Akoenigs2/SodaShop/PCB Design/sodaShop3D.png

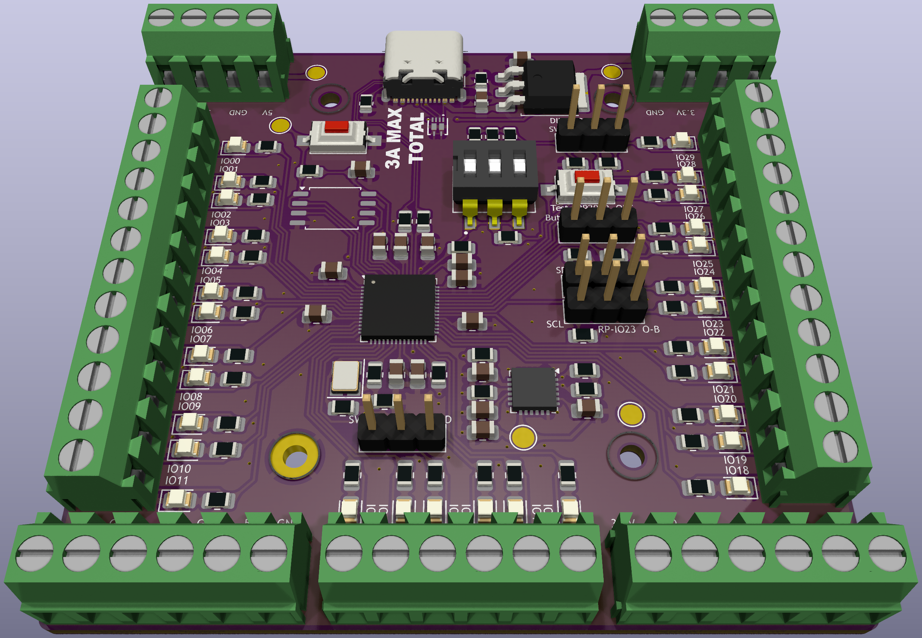
PCB Design/sodaShop3D.png
