Akoenigs2/SodaShop/Pictures/IMG_20250502_105455233.jpg

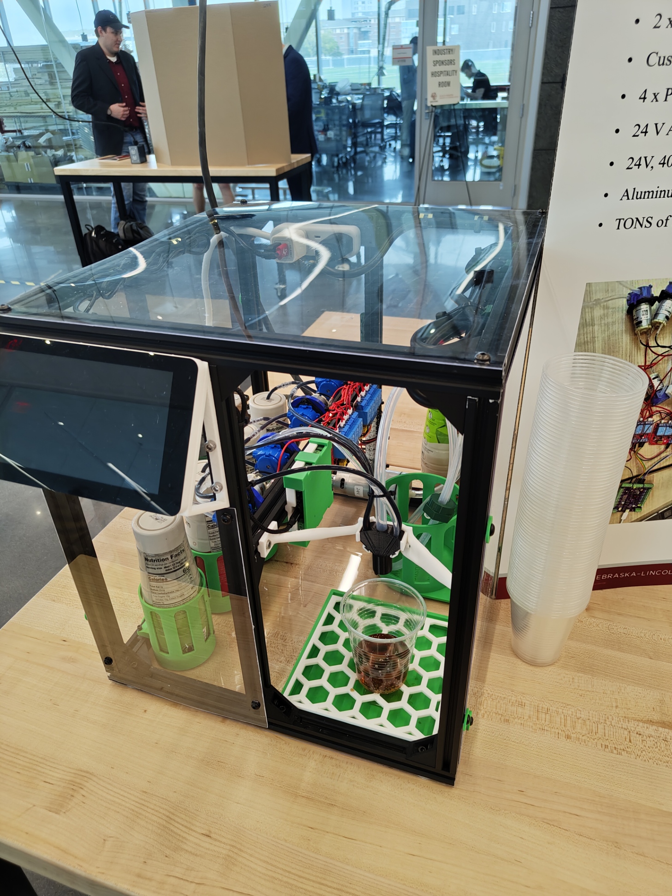
Pictures/IMG_20250502_105455233.jpg
