Akoenigs2/SodaShop/Senior Design Presentation/G185 SodaShop.pptx

## Senior Design Project: SodaShop

University of Nebraska – Lincoln
Department of Electrical and Computer Engineering

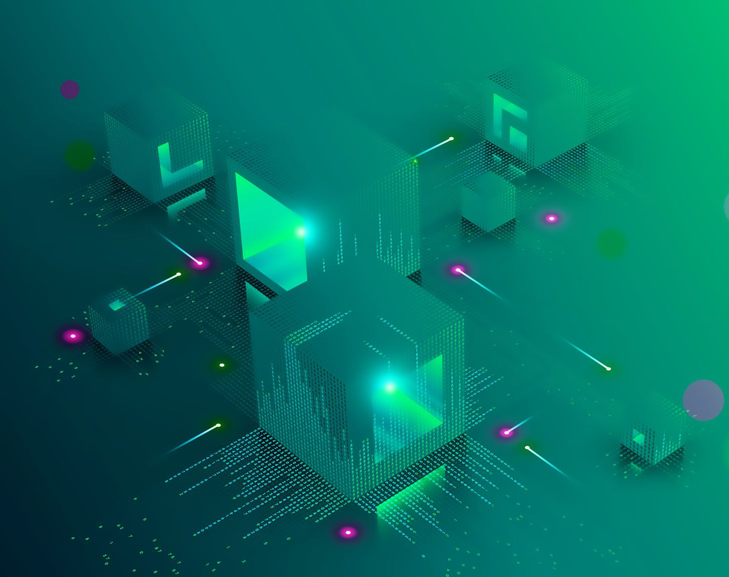
[picture p3: figure]

Justin Kleen, Austin Koenigs, Paul Litherland, Liam O’Malley, & Nic Witulski
12/6/24

## Overview

- An Outline of the Project
  - Background
  - Specifications
  - Explanation
  - Results
  - Conclusion
  - References

## Background & Problem to be Solved

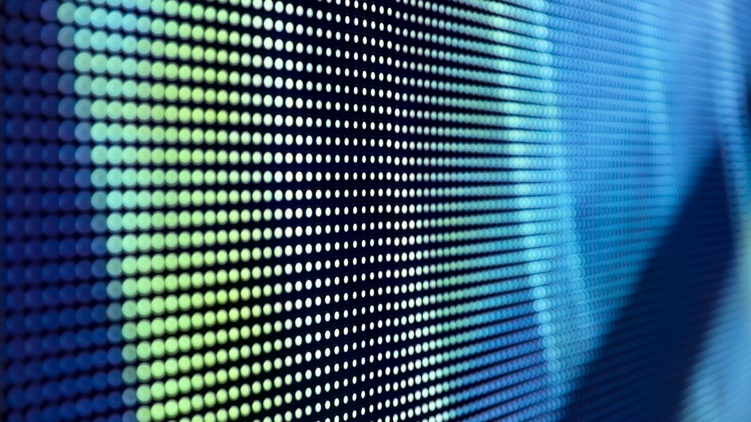
[picture p4: figure]

- Cans of soda and other soda mixing machines do not allow for customer customization and control.
- SodaShop allows for the ultimate customizability and control of soft drink creation bolstered by seamless automation.

## Specifications

- 24 V operating voltage
- 6A rated current draw
- 4 peristaltic pumps
- 1 air pump
- Rasberry pi 4B
- Custom pcb with rp2040
- 2 relay boards with 4 relays each
- 7in touchscreen interface

## Explanation

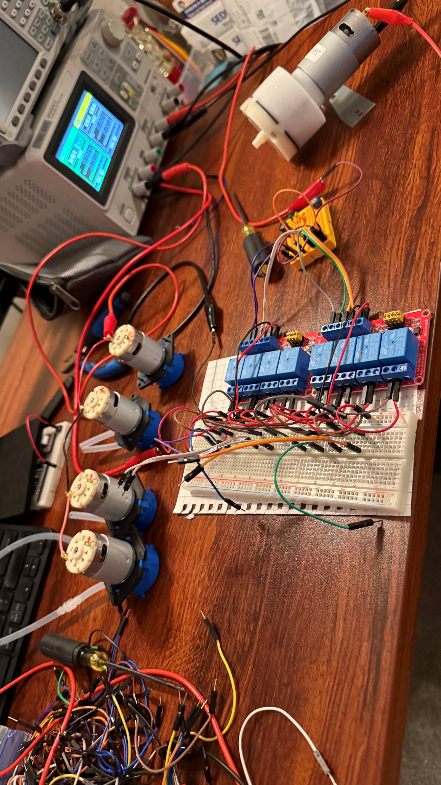
[picture p5: figure]

- UI Library:
  - GUIZero
- Relays:
  - Will be controlled by custom pcb receiving signals from raspberry pi interface
- Food Safety

## Summary

- Functional UI
- Automatic pumping and pouring of drinks

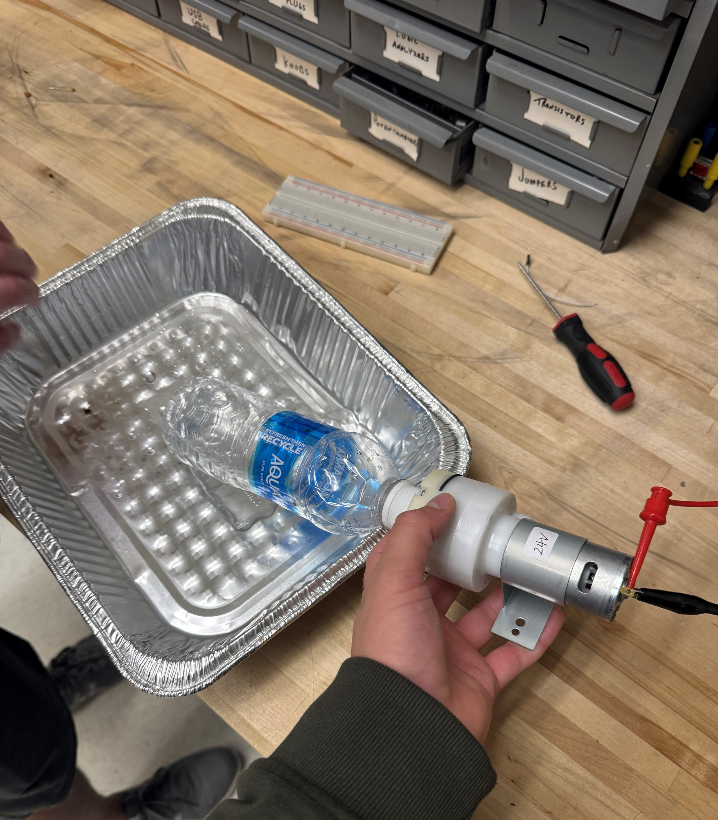
[picture p6: figure]

## References

## Conclusion

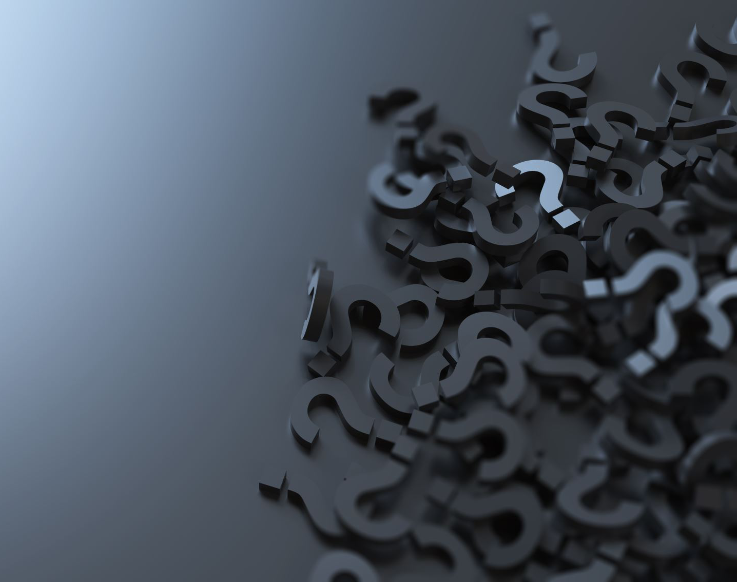
[picture p7: figure]
Many question marks on black background

- Thank you!!
- Questions?
