Akoenigs2/SodaShop/Spec Sheet/G185_ECEN495_SodaShop_Spec_Sheet.pdf

Justin Kleen – Austin Koenigs – Paul Litherland – Liam O’Malley – Nic Witulski

# SodaShop

7” Touchscreen Interface | Carbonated –or– Still Water | Up to Four Syrup Options | 120 VAC | 69 W

Pumping Current/Power
sxWater | 0.41 A | 09.84 W
+1 Syrups | 0.61 A | 14.64 W
+2 Syrups | 0.82 A | 19.68 W
+3 Syrups | 1.03 A | 24.72 W
+4 Syrups | 1.24 A | 29.76 W

Standard Features
- Operation is controlled via a 7” touchscreen providing the user with complete control of ratios between water and each individual flavor.
- SodaShop allows a selection of pre-determined volumes at a press of a button.
- SodaShop is capable of storing hundreds of flavor combinations and five user-determined favorite recipes.
- Stored combinations automatically fall into valid and invalid recipe bins based on the entered current syrups installed to inform the user of selectable saved combinations based on current availability.
- Favorites can quickly be dispensed from the home screen to provide a drink with minimal wait time.
- The system can plug directly into a wall 120VAC outlet to provide fast and easy access and operation.
- SodaShop uses four peristaltic pumps for syrup control providing precise control and easy-to-swap tubing for replacement and cleaning.
- Main water is pumped via air pressure to prevent cavitation maximizing carbonation for the optimal drinking experience. This method also provide self-pressure relief preventing overpressure conditions in the water container.
- The system is designed to allow any standard 2-liter bottle for water. Flavors are currently relegated to using third-party syrups bottle with modified caps.

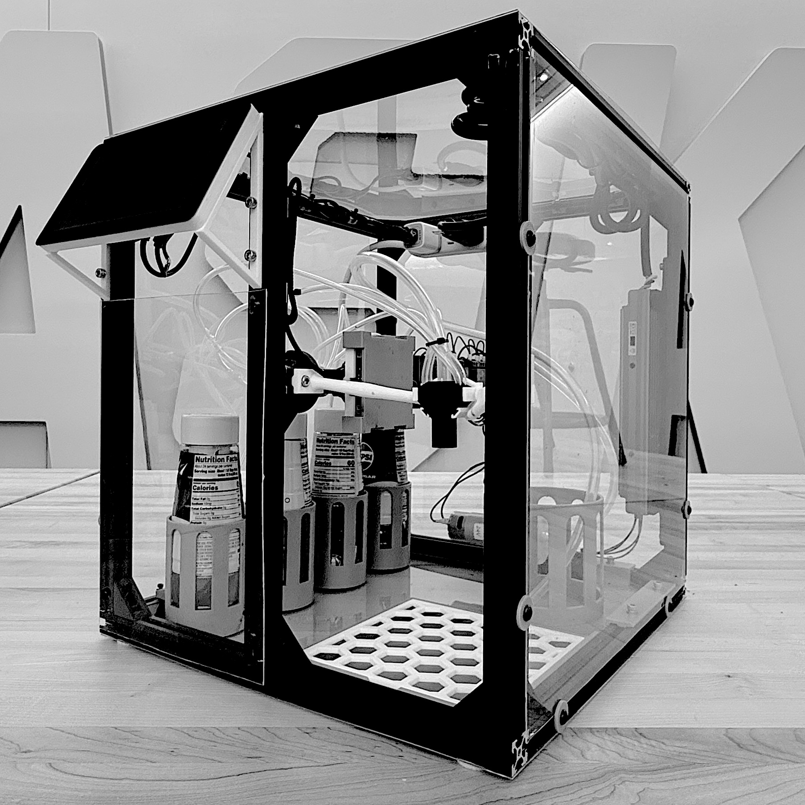
[picture p17: figure]

## Component Ratings

24 VDC Power Supply | AC Input | DC Output | Rated Current | Rated Power | Input Freq | Input Type
100-240 VAC | 24 VDC | 6 A | 144 W | 50-60 Hz | 3-Terminal AC
5 VDC Power Supply | AC Input | DC Output | Rated Current | Rated Power | Input Freq | Input Type
110-220 VAC | 5 VDC | 3 A | 15 W | 50-60 Hz | 2-Terminal AC
Main Water (Air) Pump | Voltage | Max Power | Tubing Size | Flow Rate | Max Pressure | Safety
24 VDC | 10 W | 5/32” ID | ∼ 60 oz/min | 65 kPa | Overpressure
Peristaltic Syrup Pumps (4) | Voltage | Max Power | Tubing Size | Flow Rate | Motor Life | Rollers
24 VDC | 5 W | 3 mm ID | 90 ml/min | 800 hrs | 3

System Tubing

Main Water & Air | Flavors/Syrup
Inner Diameter: | 5/32” | 3 mm
Outer Diameter: | 1/4” | 5 mm
Raspberry Pi — RP2040 | Voltage | Max Power | Communication | GPIO Voltage
5 VDC | 15 W | Serial (USB-C) | 3.3 VDC
Display | Voltage | Max Power | Communication | Size | Touch
5 VDC | 15 W | Direct | 7 ” | Capacitive
Motor Control Relays | Voltage | Max Load (Each) | Safety | Trig. Voltage/Current
24 VDC | 30 VDC — 10 A | Opto-Isolation | 0-8 V (low) — 5 mA

UNL G185 EE Capstone 2024–2025-1
