Akoenigs2/SodaShop/PCB Design/sodaShopLayout.png

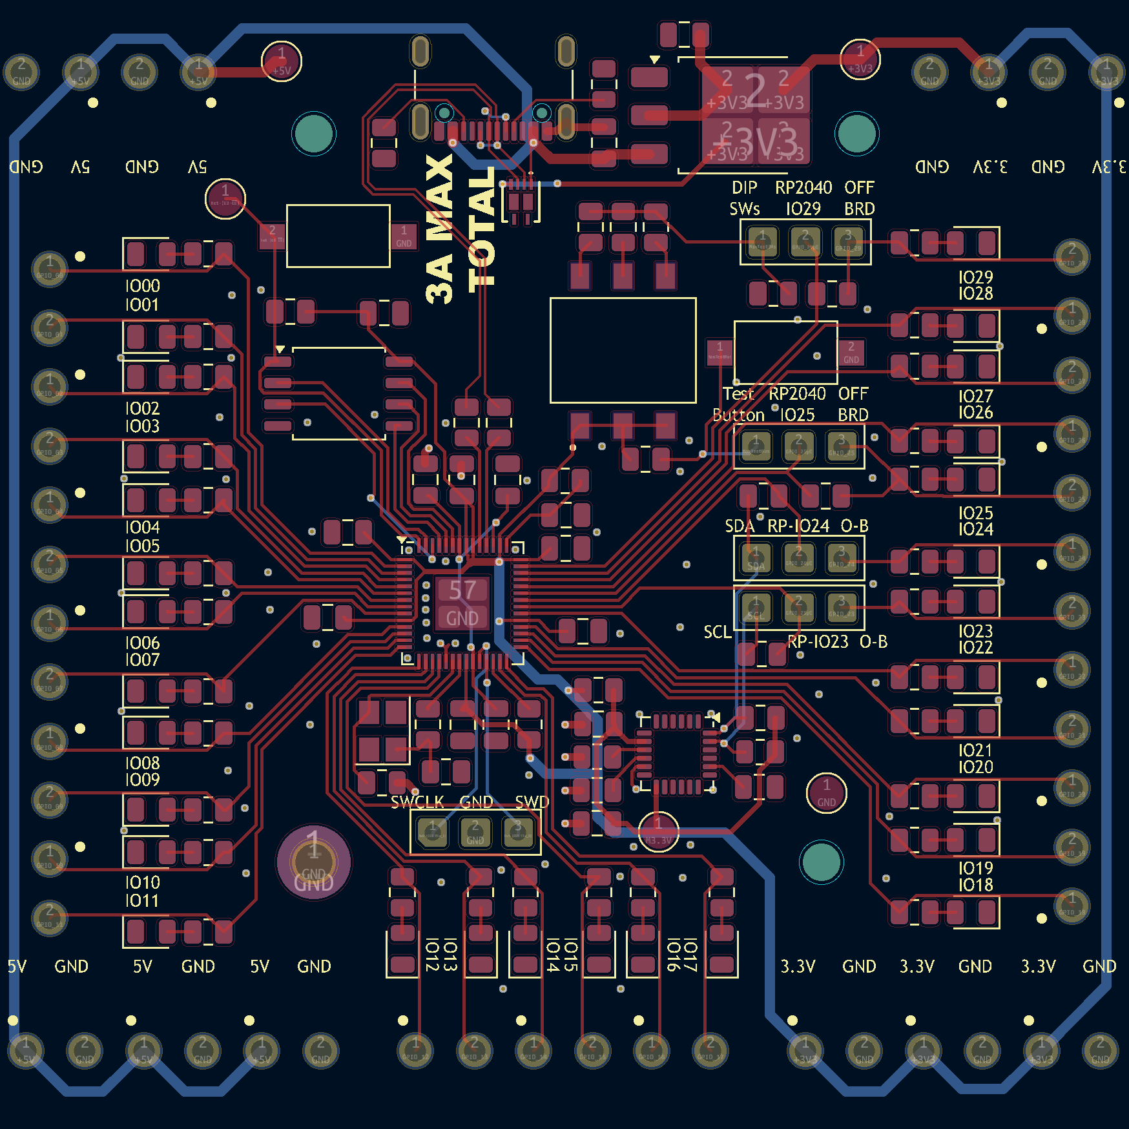
PCB Design/sodaShopLayout.png
