Akoenigs2/SodaShop/Pictures/IMG_20250225_141645415.jpg

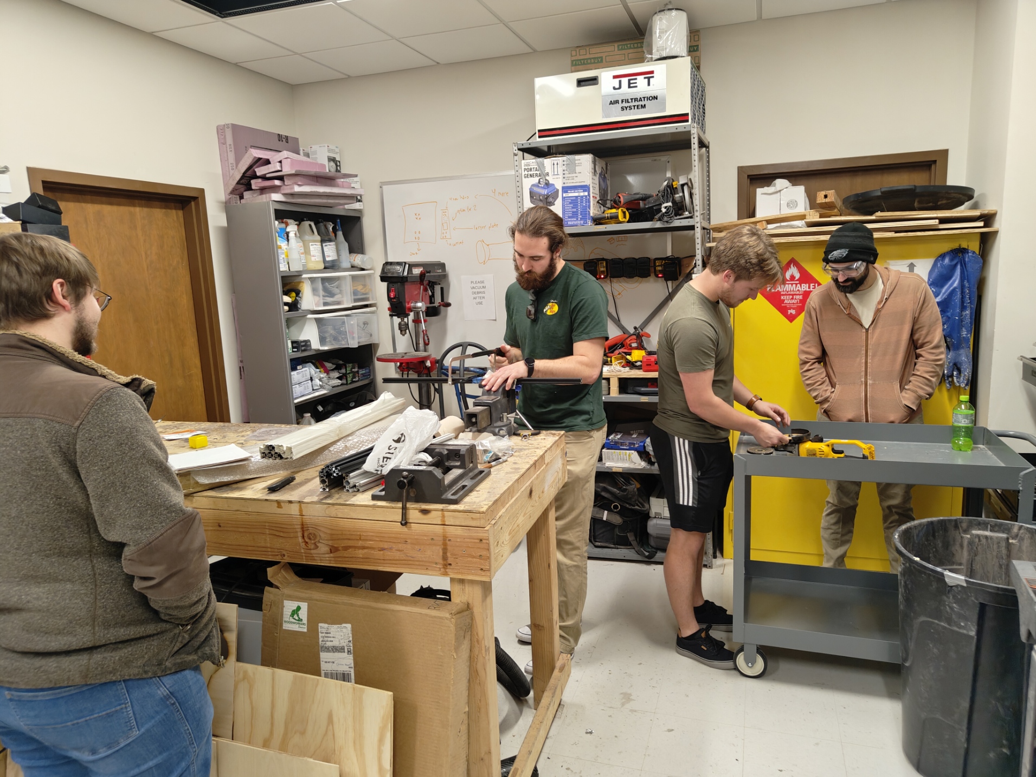
Pictures/IMG_20250225_141645415.jpg
