Akoenigs2/SodaShop/Pictures/IMG_20250225_143517592.jpg

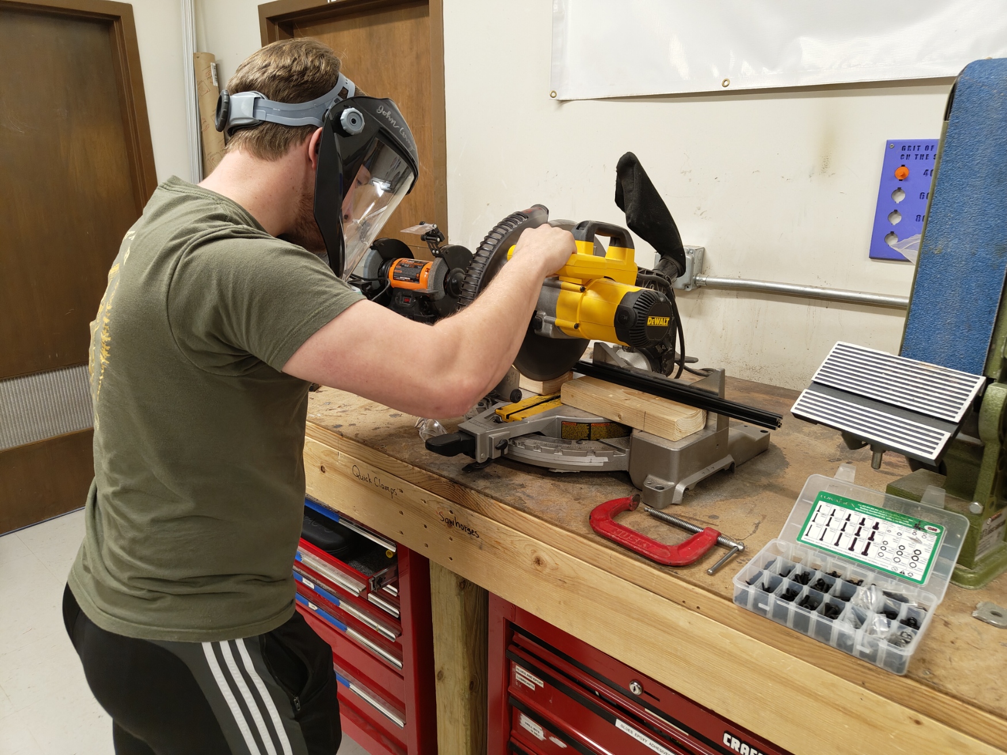
Pictures/IMG_20250225_143517592.jpg
