Akoenigs2/SodaShop/Pictures/IMG_20250225_143700488.jpg

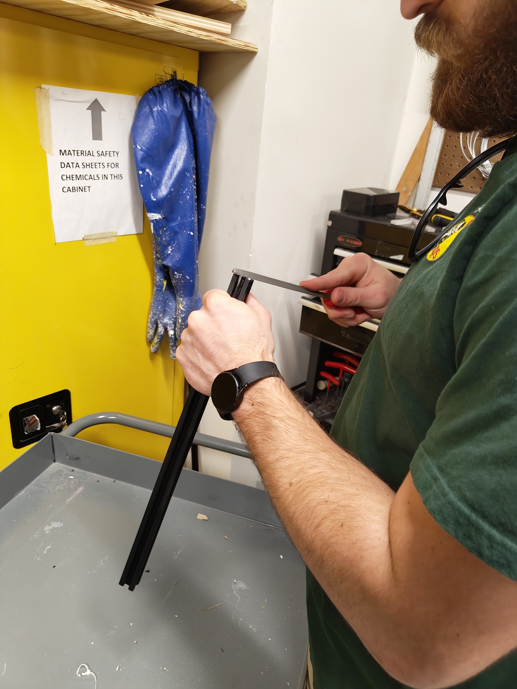
Pictures/IMG_20250225_143700488.jpg
