Akoenigs2/SodaShop/Pictures/IMG_20250304_141928702.jpg

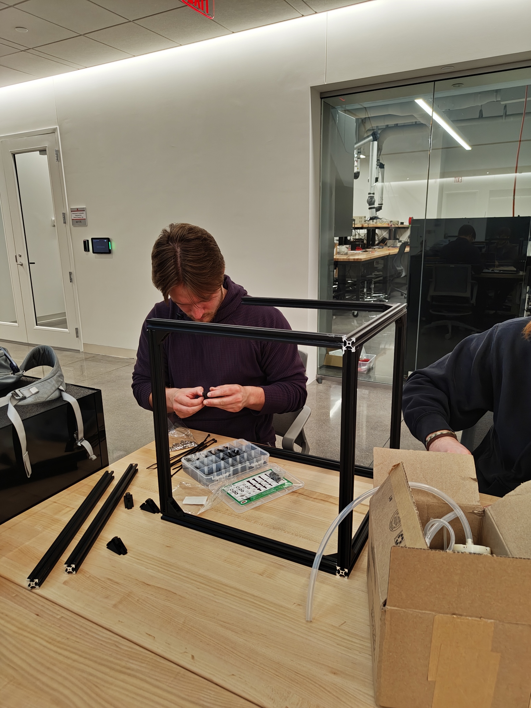
Pictures/IMG_20250304_141928702.jpg
