Akoenigs2/SodaShop/Pictures/IMG_20250304_145719513.jpg

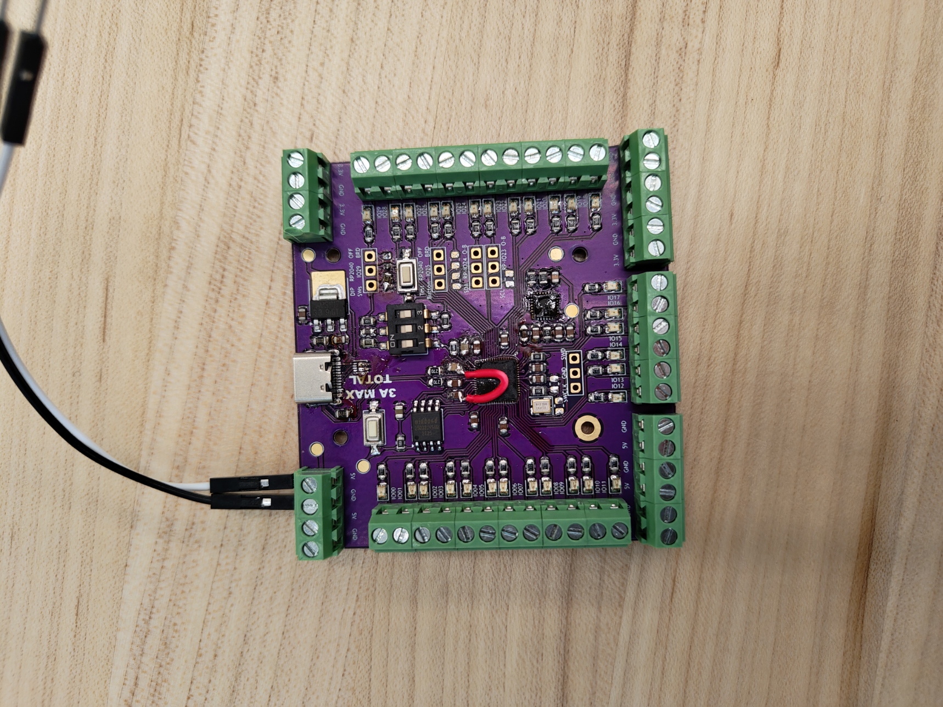
Pictures/IMG_20250304_145719513.jpg
