Akoenigs2/SodaShop/Pictures/IMG_20250325_144047182.jpg

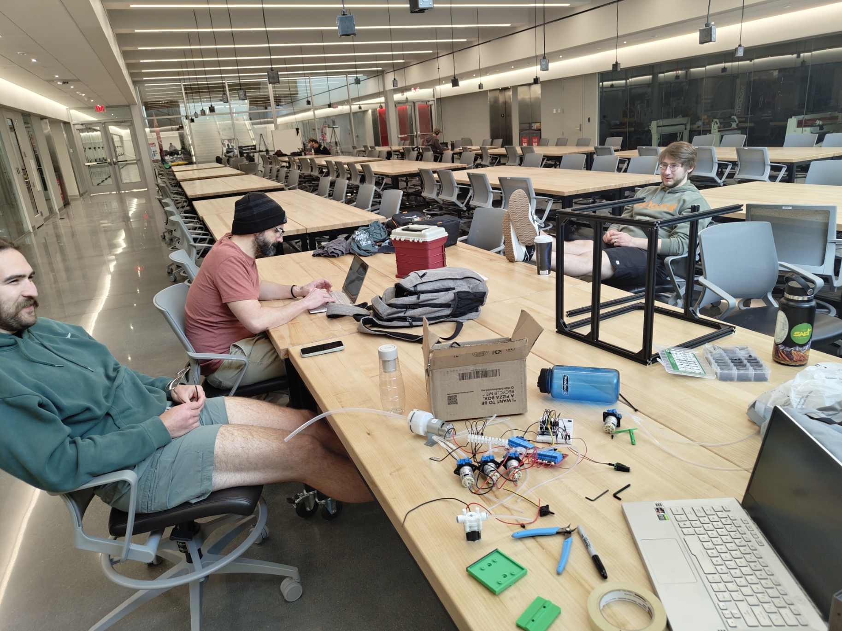
Pictures/IMG_20250325_144047182.jpg
