Akoenigs2/SodaShop/Pictures/IMG_20250325_145647819.jpg

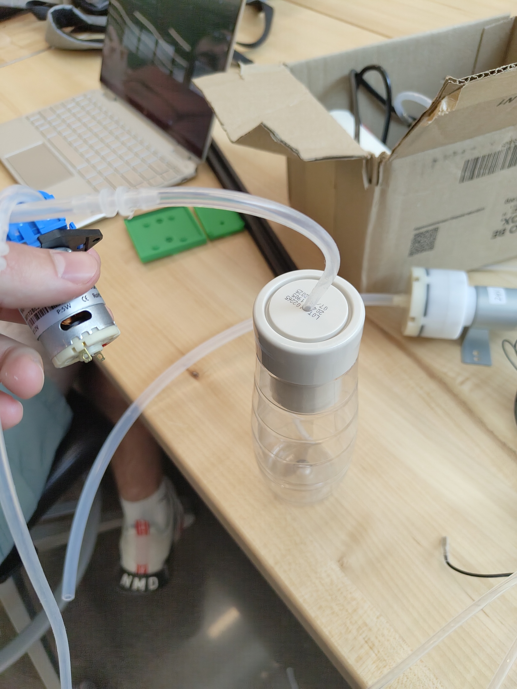
Pictures/IMG_20250325_145647819.jpg
