Akoenigs2/SodaShop/Pictures/IMG_20250401_142619781.jpg

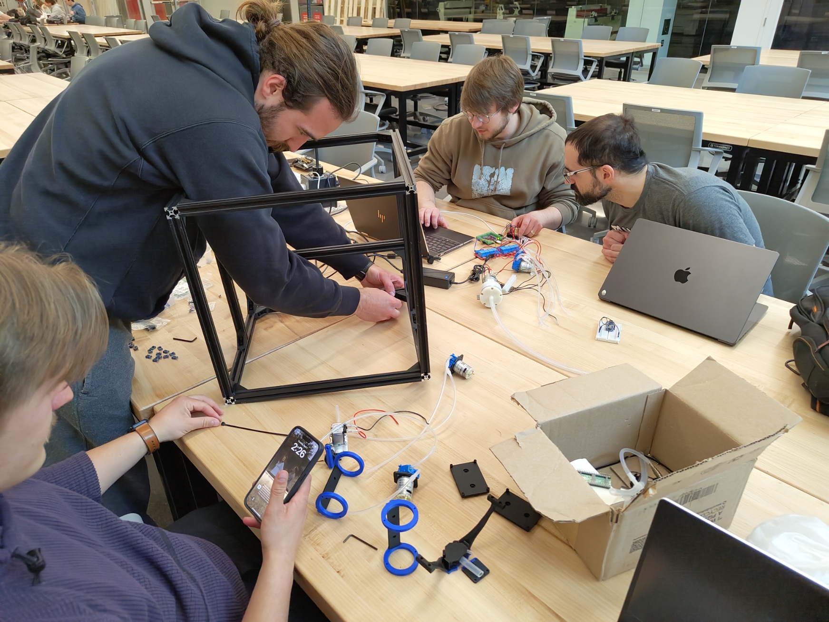
Pictures/IMG_20250401_142619781.jpg
