Akoenigs2/SodaShop/Pictures/IMG_20250401_144759305.jpg

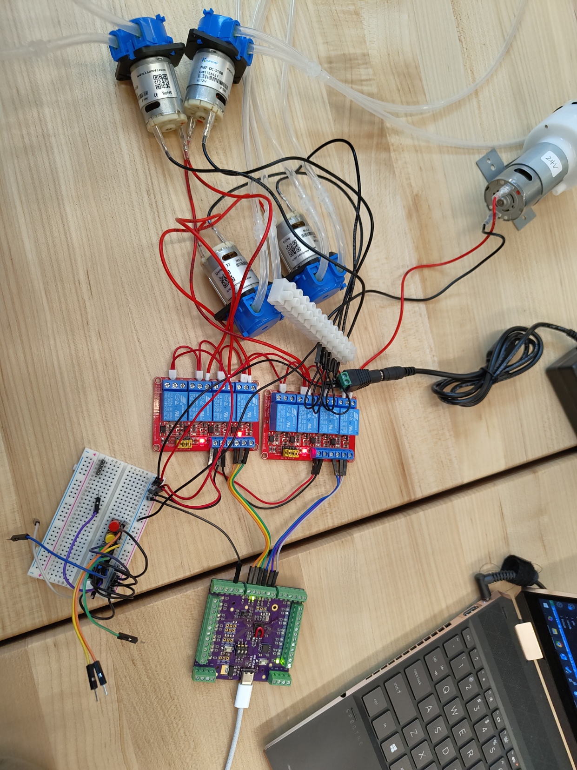
Pictures/IMG_20250401_144759305.jpg
