Akoenigs2/SodaShop/Pictures/IMG_20250402_194000655.jpg

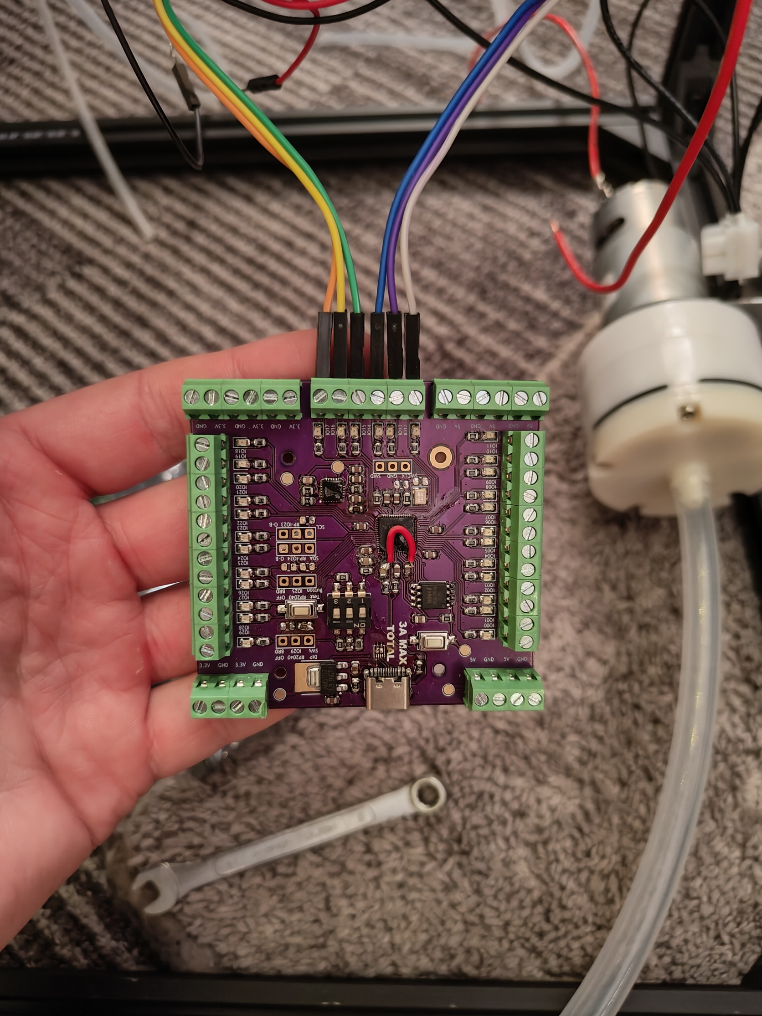
Pictures/IMG_20250402_194000655.jpg
