Akoenigs2/SodaShop/Pictures/IMG_20250408_150435291.jpg

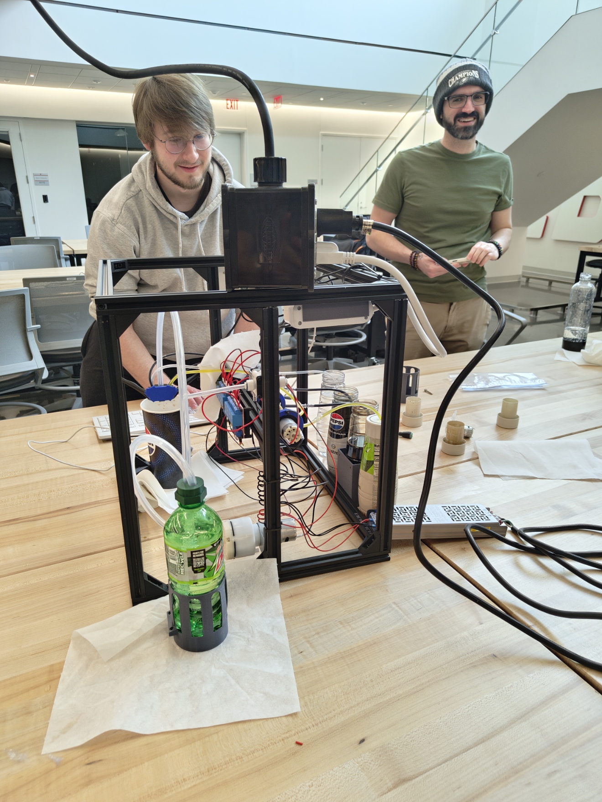
Pictures/IMG_20250408_150435291.jpg
