Akoenigs2/SodaShop/Pictures/IMG_20250423_213137417.jpg

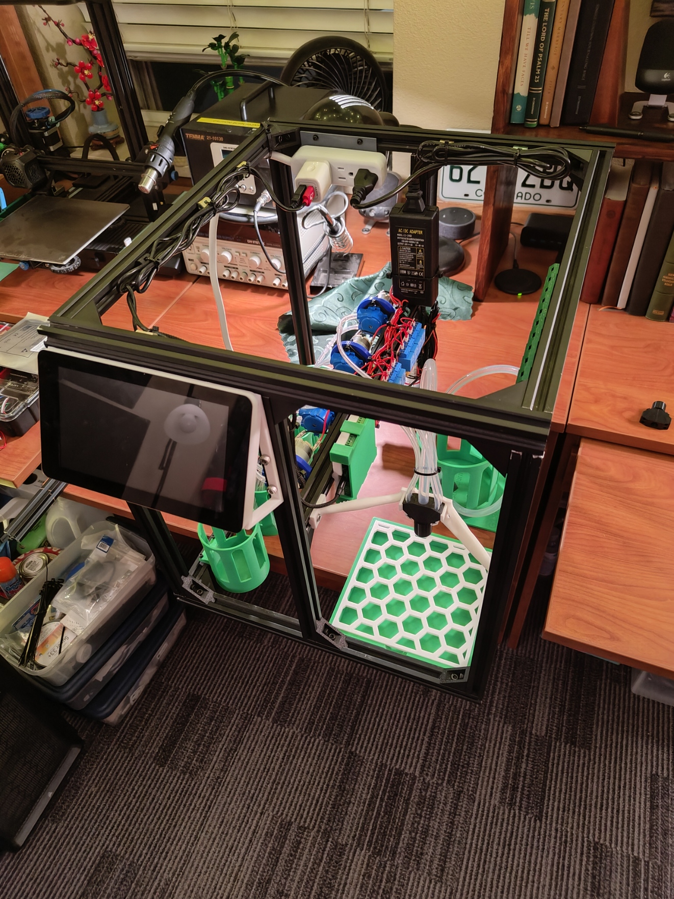
Pictures/IMG_20250423_213137417.jpg
