Akoenigs2/SodaShop/Pictures/IMG_20250423_213144863.jpg

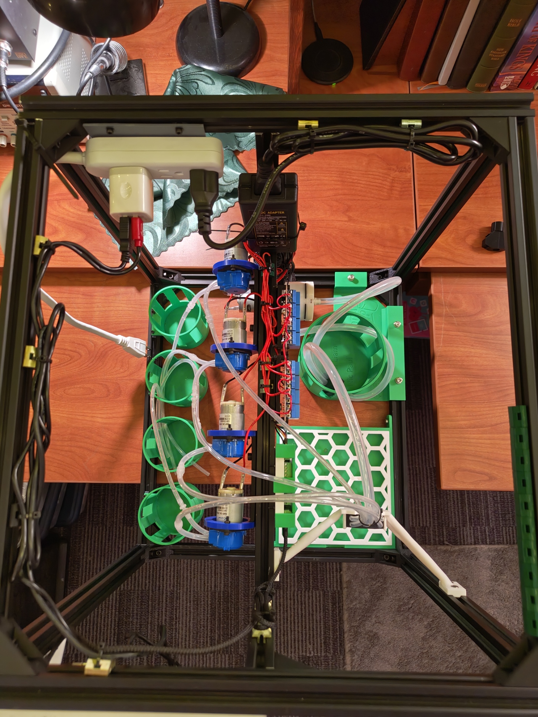
Pictures/IMG_20250423_213144863.jpg
