Akoenigs2/SodaShop/Pictures/IMG_20250502_105539470.jpg

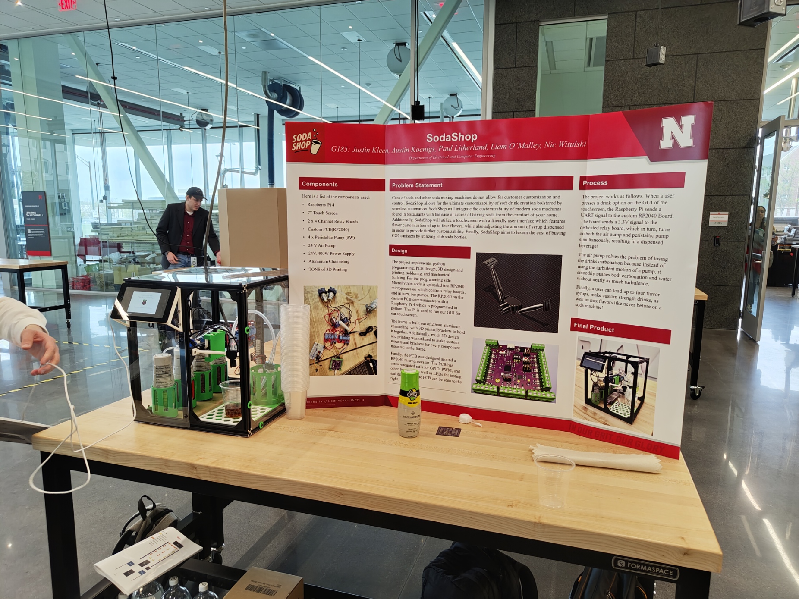
Pictures/IMG_20250502_105539470.jpg
