Akoenigs2/SodaShop/Pictures/IMG_20250502_141535261.jpg

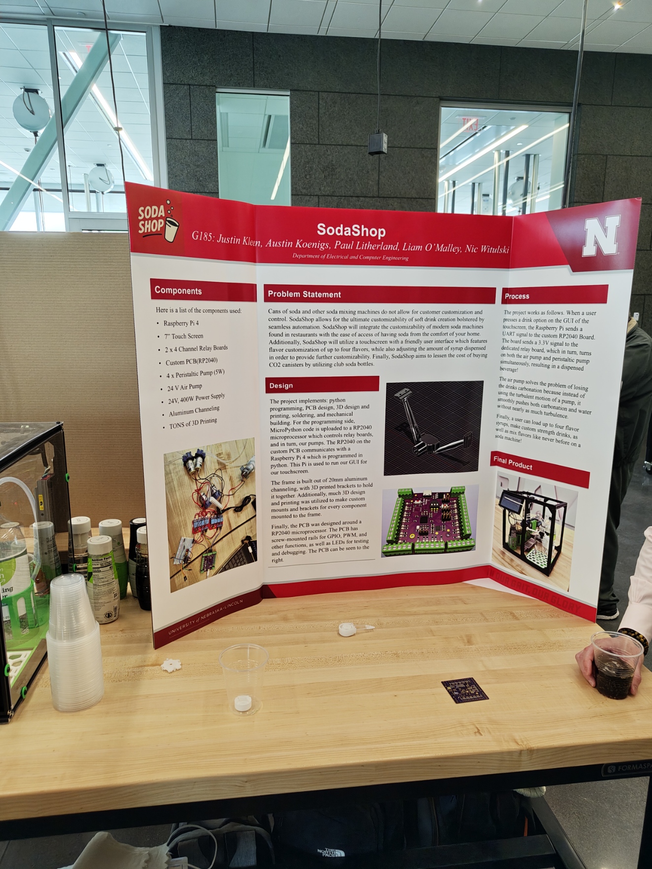
Pictures/IMG_20250502_141535261.jpg
