Akoenigs2/SodaShop/Spec Sheet/Reference Documentation/peristaltic pump info.png

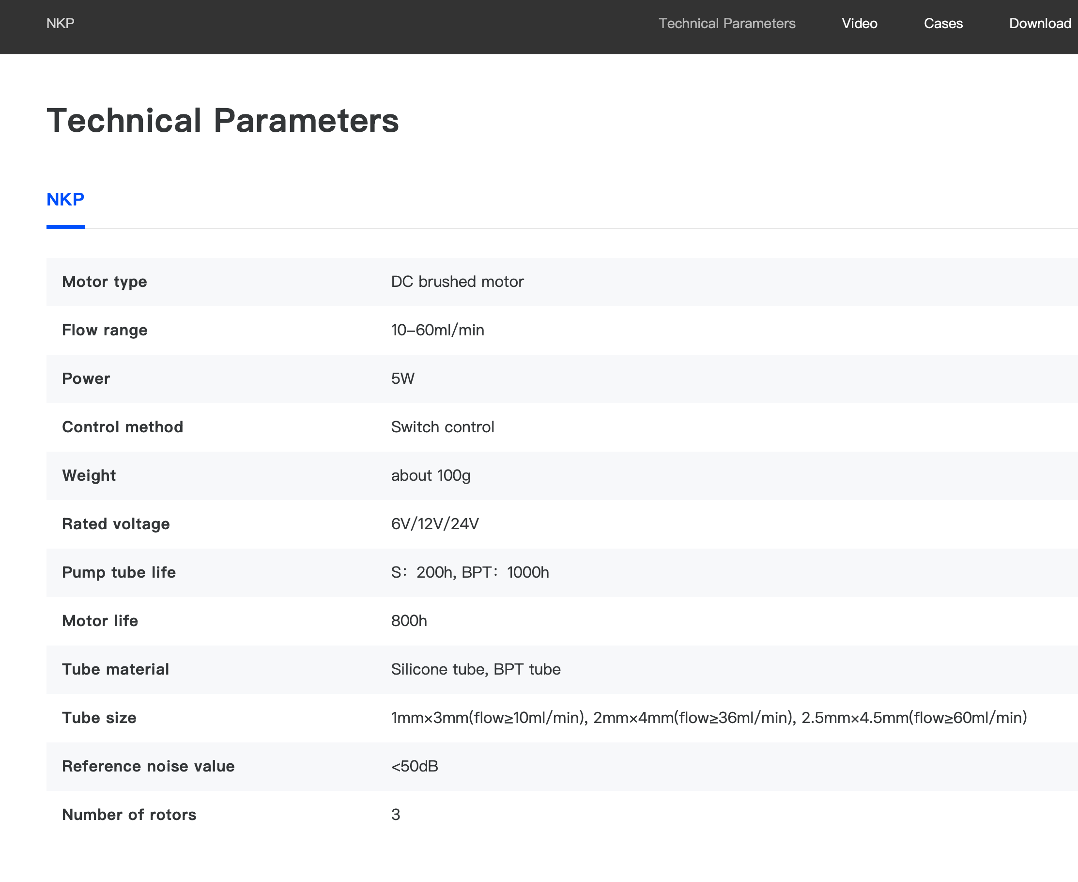
Spec Sheet/Reference Documentation/peristaltic pump info.png
