Akoenigs2/SodaShop/3D Objects/Bottle Cap/BottleCap.stl

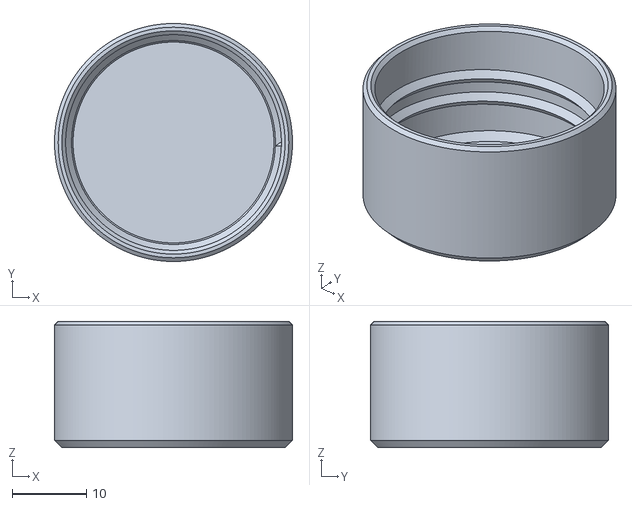
[picture p36: CAD file, 2025-05-07]
3D Objects/Bottle Cap/BottleCap.stl
32.0 x 32.0 x 17.0
