Akoenigs2/SodaShop/3D Objects/V-Slot Small Pump Mount v8.stl

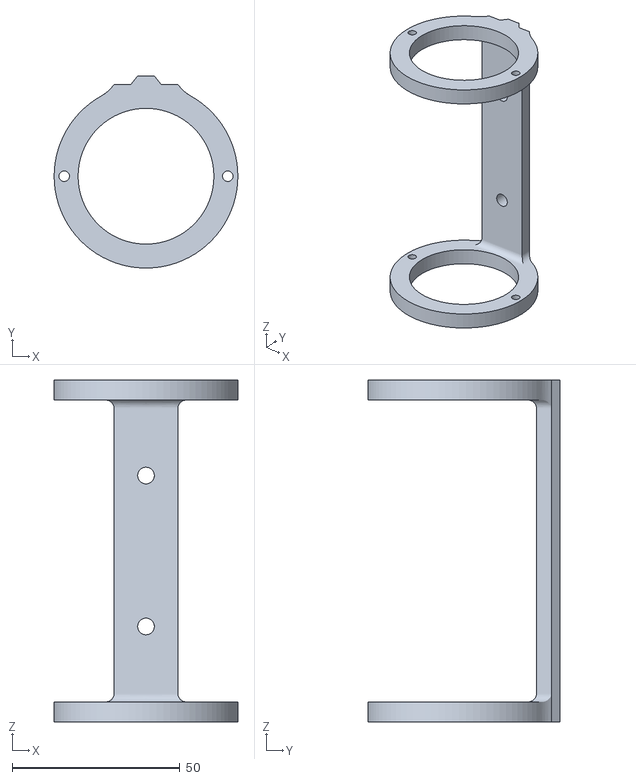
[picture p37: CAD file, 2025-05-07]
3D Objects/V-Slot Small Pump Mount v8.stl
54.8 x 57.3 x 102.0
