Akoenigs2/SodaShop/3D Objects/Bottle Cap/BottleCapwithPlugs.stl

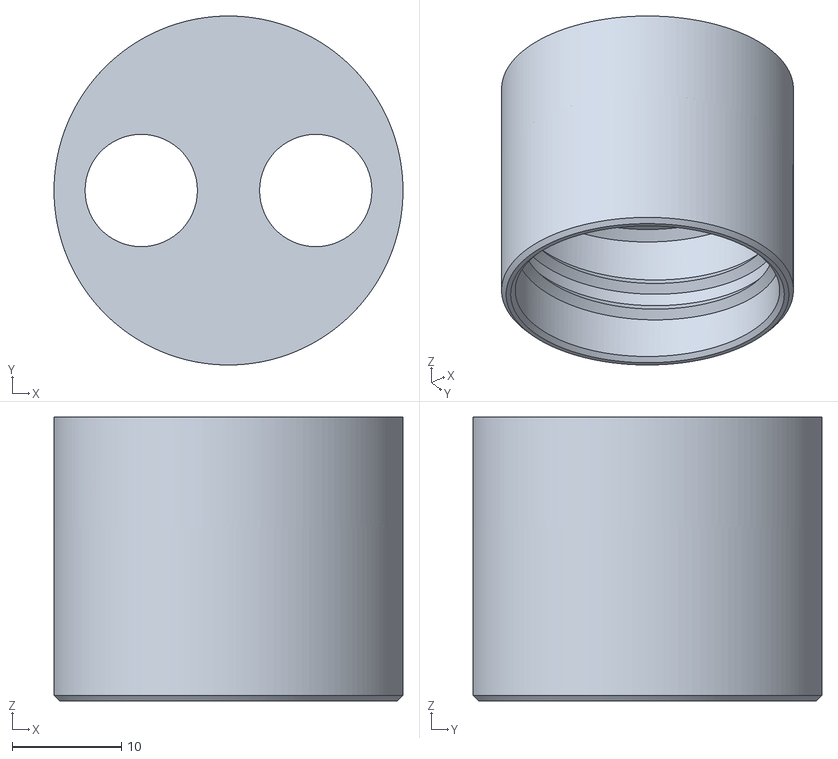
[picture p38: CAD file, 2025-05-07]
3D Objects/Bottle Cap/BottleCapwithPlugs.stl
32.0 x 32.0 x 26.0
