Akoenigs2/SodaShop/3D Objects/V-Slot Clip v1.stl

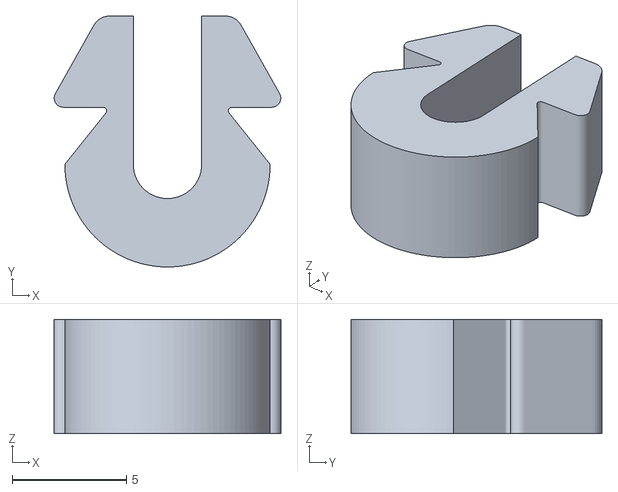
[picture p39: CAD file, 2025-05-07]
3D Objects/V-Slot Clip v1.stl
9.93 x 11.0 x 5.00
