Akoenigs2/SodaShop/3D Objects/Dish.stl

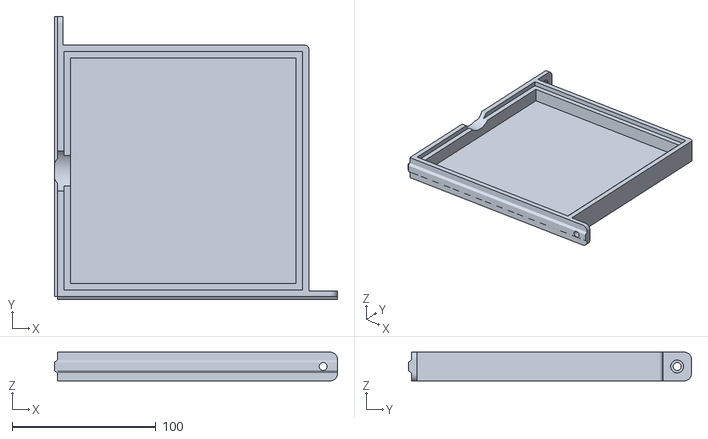
[picture p40: CAD file, 2025-05-07]
3D Objects/Dish.stl
197.0 x 197.0 x 20.0
