Akoenigs2/SodaShop/3D Objects/Nozzle Mount BACKWARDS.stl

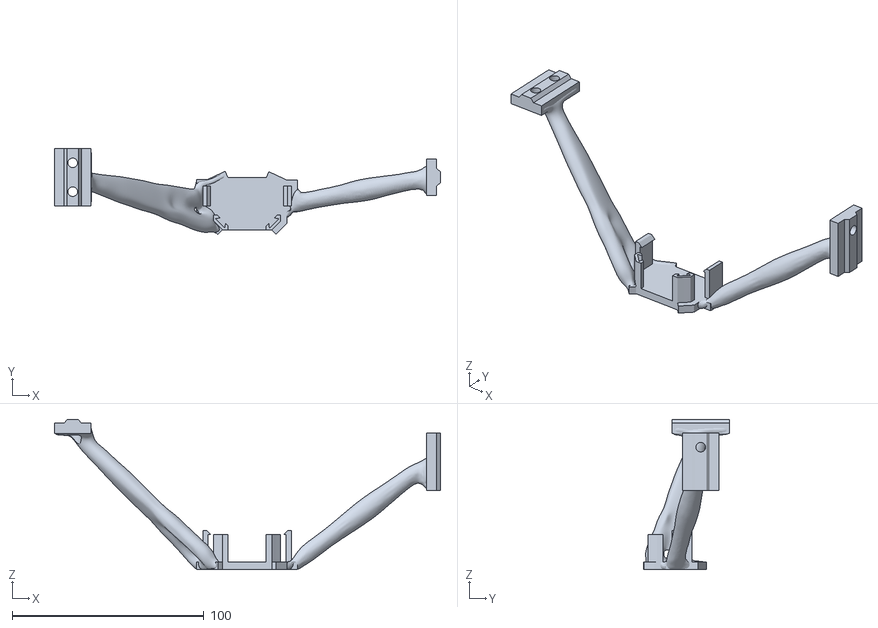
[picture p41: CAD file, 2025-05-07]
3D Objects/Nozzle Mount BACKWARDS.stl
201.1 x 44.8 x 78.3
