Akoenigs2/SodaShop/3D Objects/Pressure Sensor Mount v3.stl

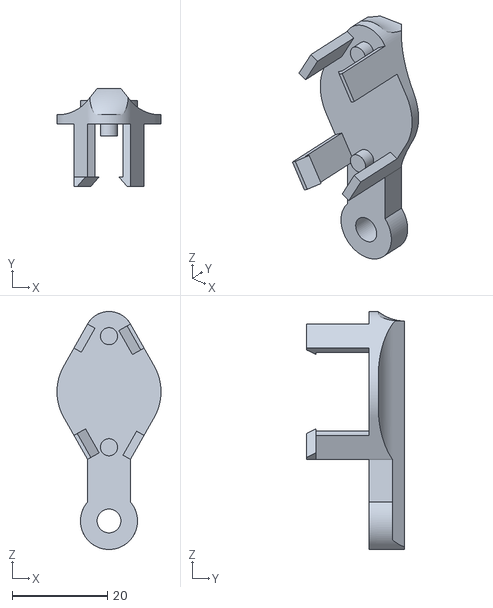
[picture p42: CAD file, 2025-05-07]
3D Objects/Pressure Sensor Mount v3.stl
21.9 x 20.6 x 50.0
