Akoenigs2/SodaShop/3D Objects/Syrup Bottle Bracket v2.stl

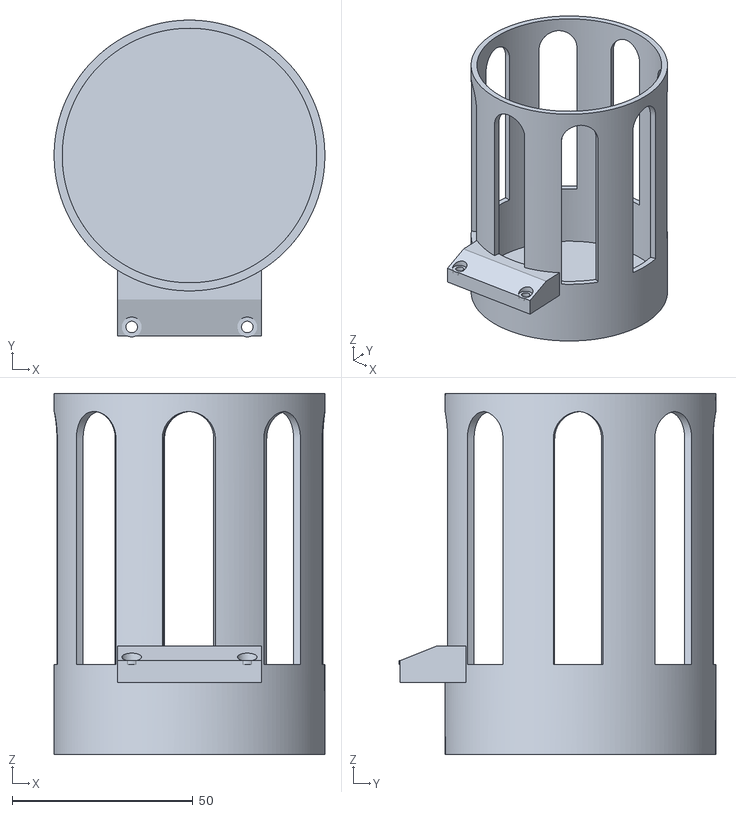
[picture p43: CAD file, 2025-05-07]
3D Objects/Syrup Bottle Bracket v2.stl
75.0 x 87.7 x 100.0
