Akoenigs2/SodaShop/3D Objects/Body1.stl

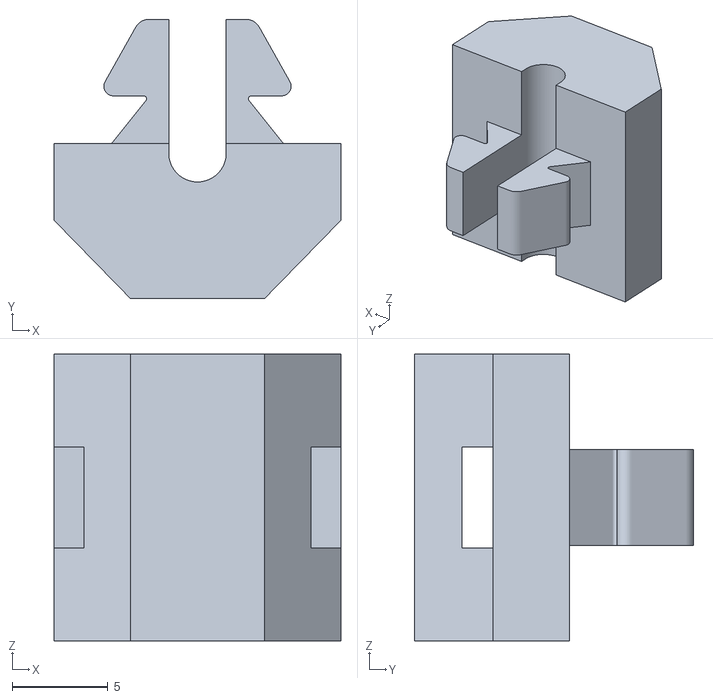
[picture p44: CAD file, 2025-05-07]
3D Objects/Body1.stl
15.0 x 14.6 x 15.0
