Akoenigs2/SodaShop/3D Objects/Soda Machine Nozzle.stl

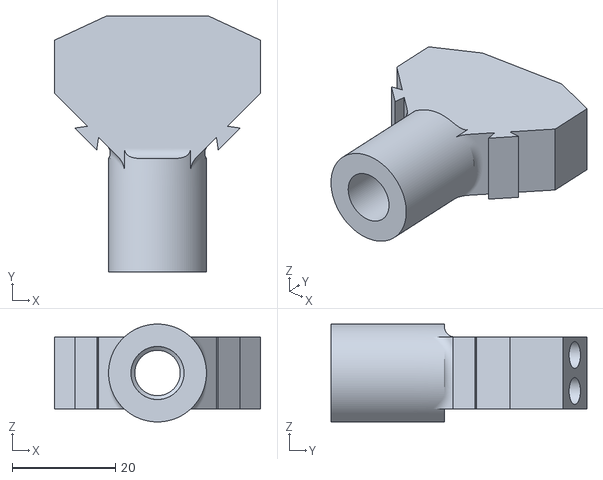
[picture p45: CAD file, 2025-05-07]
3D Objects/Soda Machine Nozzle.stl
40.0 x 49.6 x 19.0
