Akoenigs2/SodaShop/3D Objects/V-Slot Relay Mount v4.stl

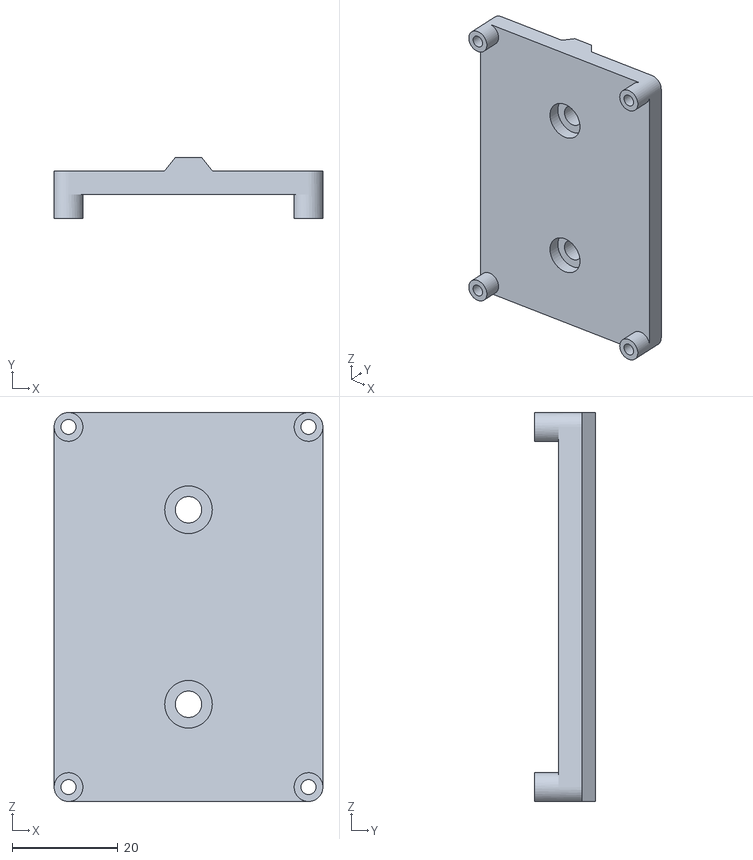
[picture p46: CAD file, 2025-05-07]
3D Objects/V-Slot Relay Mount v4.stl
50.8 x 11.5 x 73.5
