Akoenigs2/SodaShop/3D Objects/Mesh Tray.stl

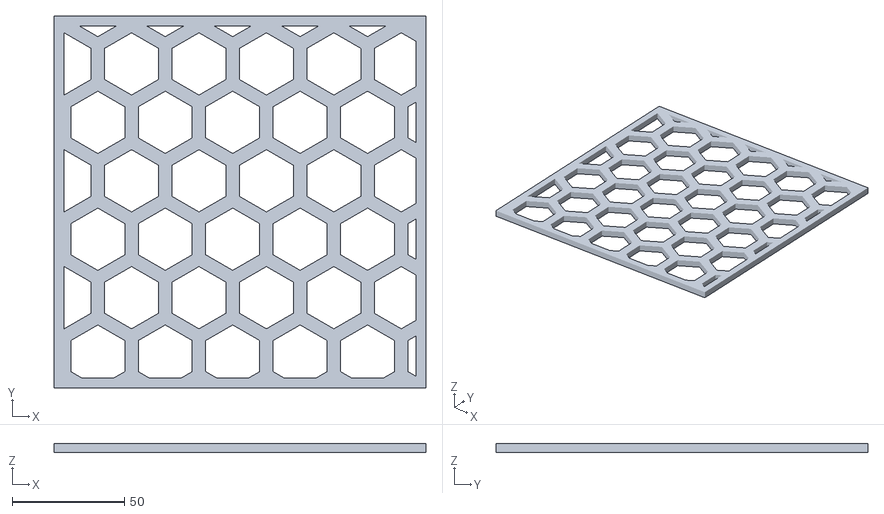
[picture p47: CAD file, 2025-05-07]
3D Objects/Mesh Tray.stl
165.5 x 165.5 x 4.00
