Akoenigs2/SodaShop/3D Objects/2L Holder.stl

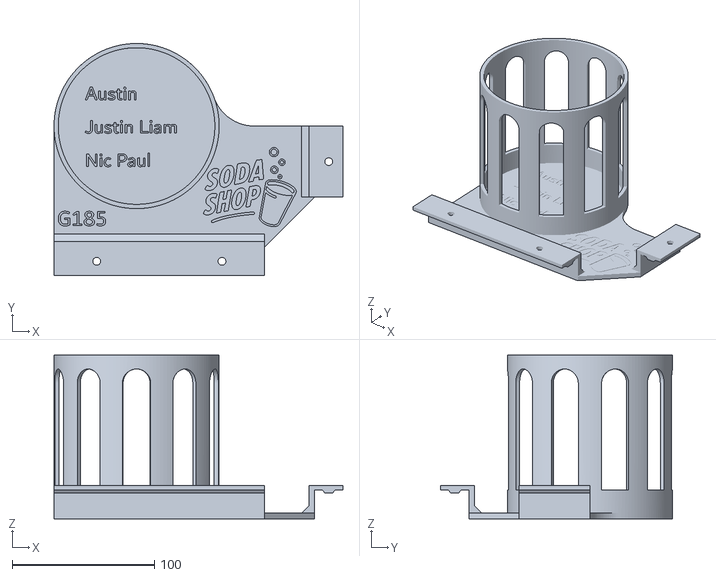
[picture p48: CAD file, 2025-05-07]
3D Objects/2L Holder.stl
203.0 x 163.0 x 115.0
