Akoenigs2/SodaShop/3D Objects/Power Supply Mount.3mf

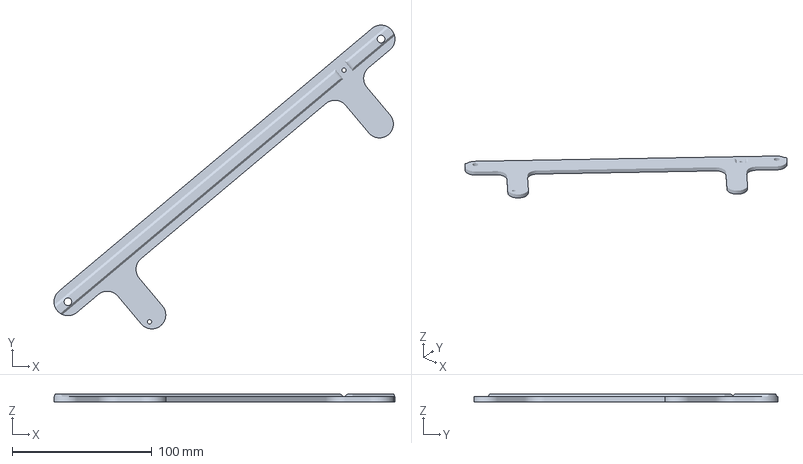
[picture p49: CAD file, 2025-05-07]
3D Objects/Power Supply Mount.3mf
244.4 x 217.8 x 6.00 mm
