Akoenigs2/SodaShop/3D Objects/PCB Cover.stl

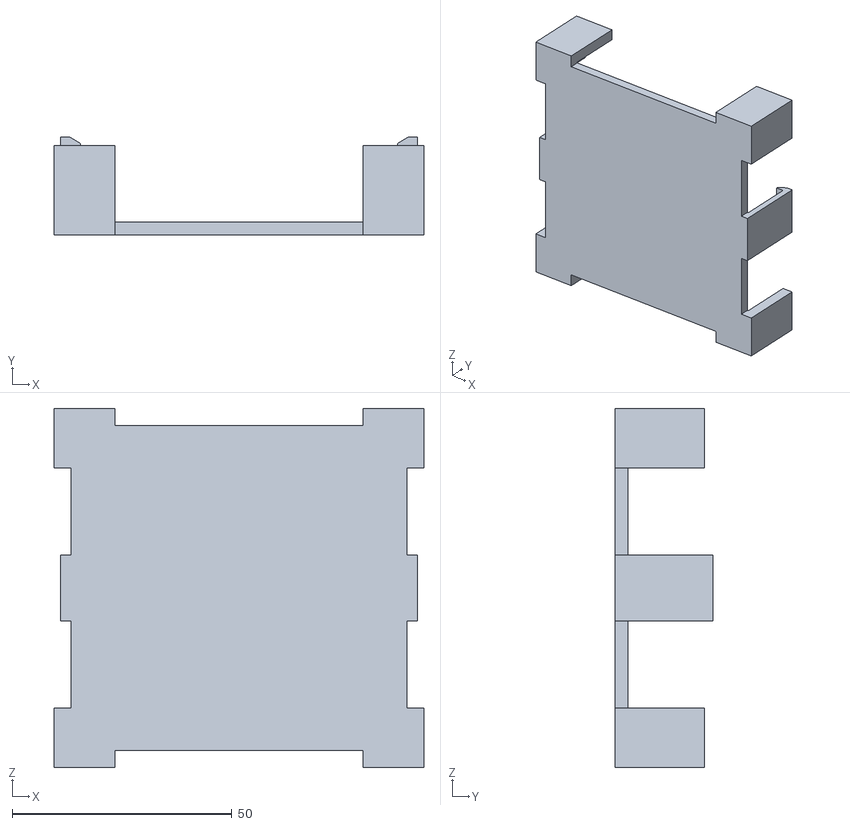
[picture p50: CAD file, 2025-05-07]
3D Objects/PCB Cover.stl
84.2 x 22.4 x 81.7
