Akoenigs2/SodaShop/3D Objects/Solenoid Pressure Valve Mount v3.stl

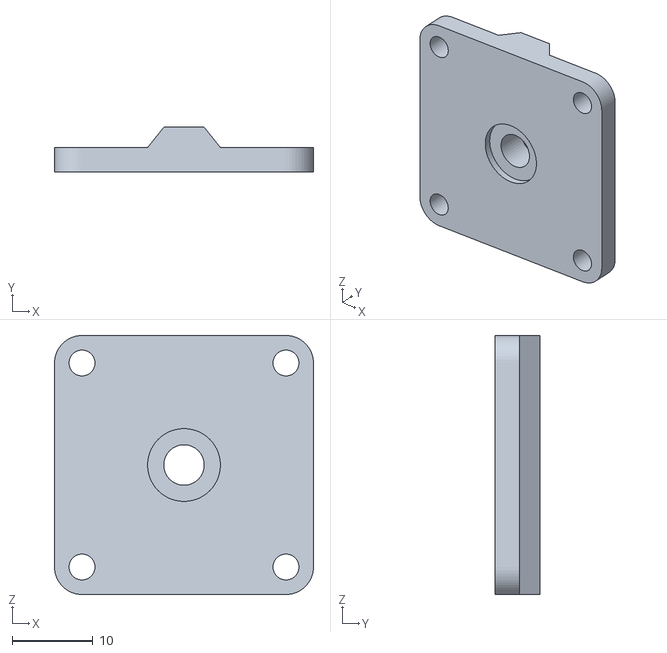
[picture p51: CAD file, 2025-05-07]
3D Objects/Solenoid Pressure Valve Mount v3.stl
32.0 x 5.50 x 32.0
