Akoenigs2/SodaShop/3D Objects/CE5S1_Enclosure Washers v4.stl

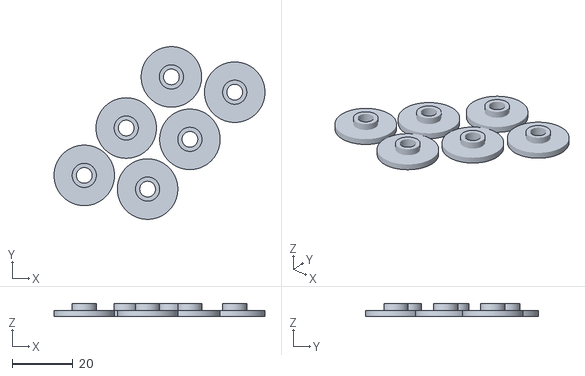
[picture p52: CAD file, 2025-05-07]
3D Objects/CE5S1_Enclosure Washers v4.stl
69.7 x 57.1 x 4.20
