Akoenigs2/SodaShop/(list of files, cad)

Other CAD files:
3D Objects/Power Supply Mount.stl
