Akoenigs2/SodaShop/PCB Design/SodaShopSchemV0.001.pdf

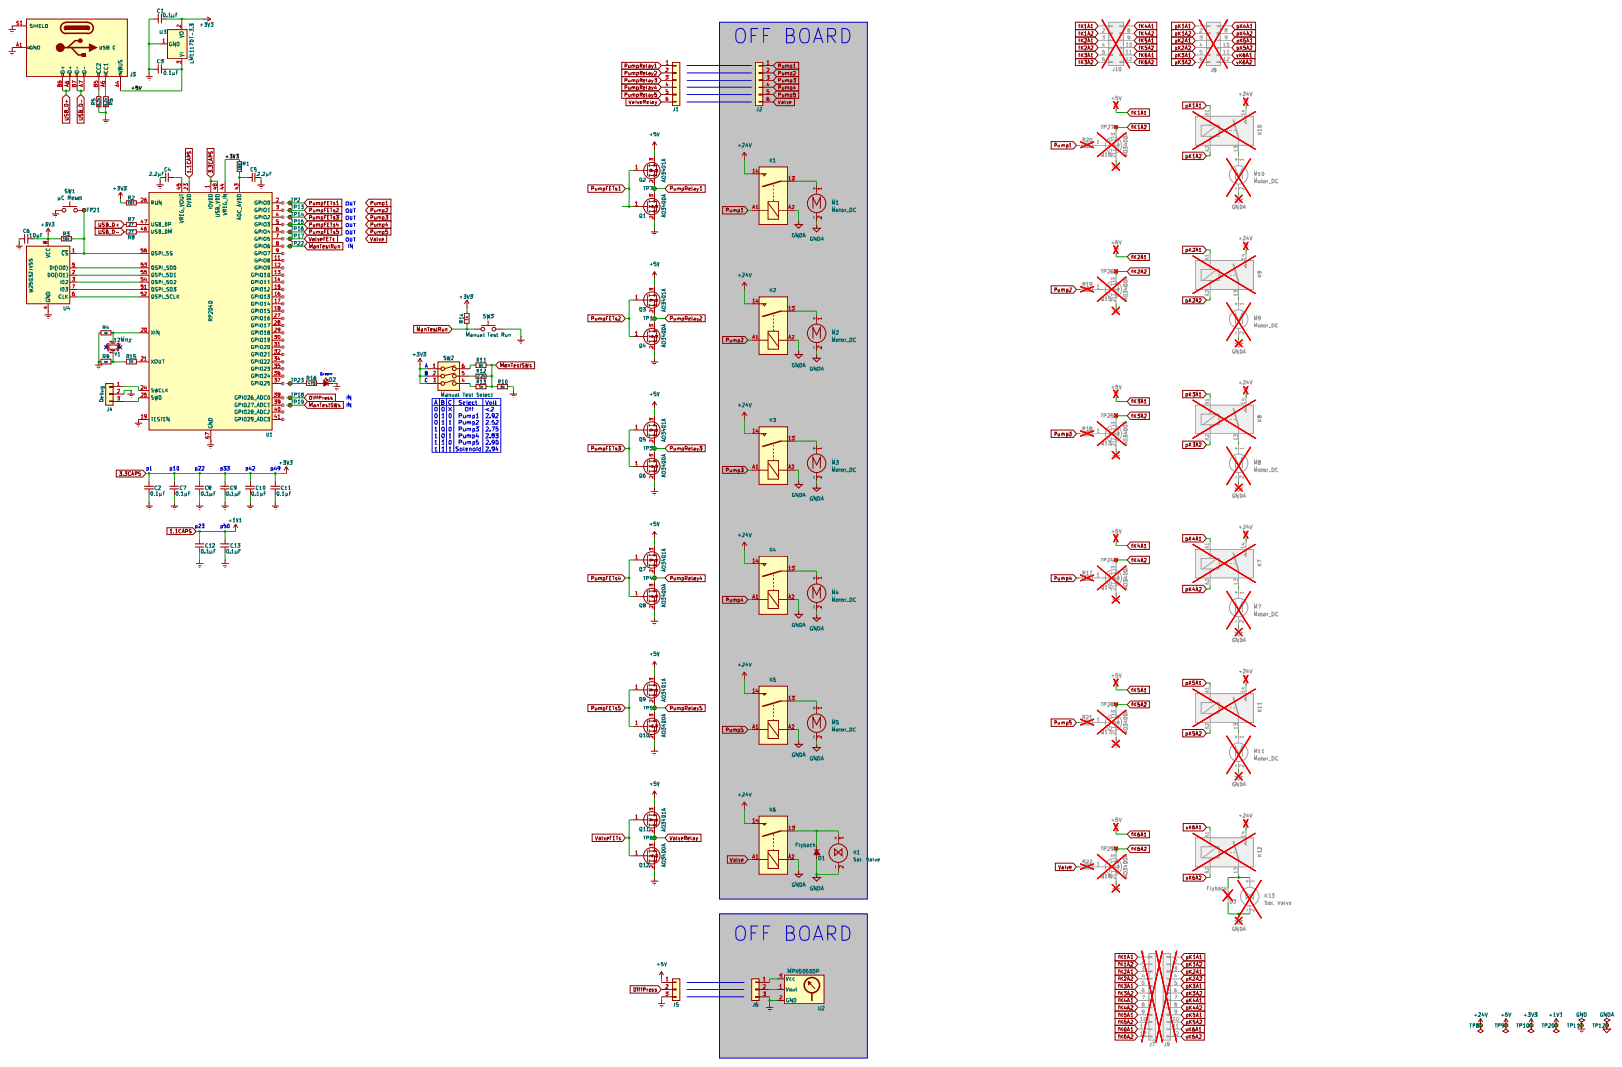
[picture p53: page 1]
