Akoenigs2/SodaShop/(commit log)

2024-11-01 Add files via upload
    initial schematic PDF of sodaShop
2024-11-01 Replaced themometer ki cad to newer version
2024-11-21 Paul pi Pico code: 11/21
2024-12-29 PCB for soda shop as it currently sits.
    may need spacing of off-board connectors, want to see how they fit once they come in. Should probably run another DRC and look for any issues, but should be in generally good shape.
2025-03-03 relay datasheet
2025-03-04 Arduino pump testing code
    takes button input and drives pump output directly (press and hold to run, release to stop)
2025-03-05 Updated corrected schematic and PCB
    Updated schematic and PCB layout to address the disconnection between pins 45 and 50 on the RP2040 (1.1V lines).
2025-04-19 kicad pix
2025-04-25 code rework, cleanup, and favorites WIP
    [flavorMenu.py, homeMenu.py, parms.py, settings.py]
2025-04-29 UI edit, some bugs
    [drinkMenu.py, favoriteMenu.py, flavorMenu.py, homeMenu.py, parms.py]
2025-05-02 final bug fix v2
    [drinkMenu.py, flavorMenu.py, flavorsOutSerial.py, parms.py]
2025-05-02 final bug fixes v5 or whatever
    [flavorsOutSerial.py]
2025-05-07 Final reorganization
    Reorganized all files, added pictures, and 3D object files to complete our github
    [2L Holder.stl, Body1.stl, BottleCap.stl, BottleCapwithPlugs.scad, BottleCapwithPlugs.stl, BottleCapwithPlugs2.scad, CE5S1_Enclosure Washers v4.stl, Dish.stl]
