Akoenigs2/SodaShop/Pictures/IMG_3029.jpg

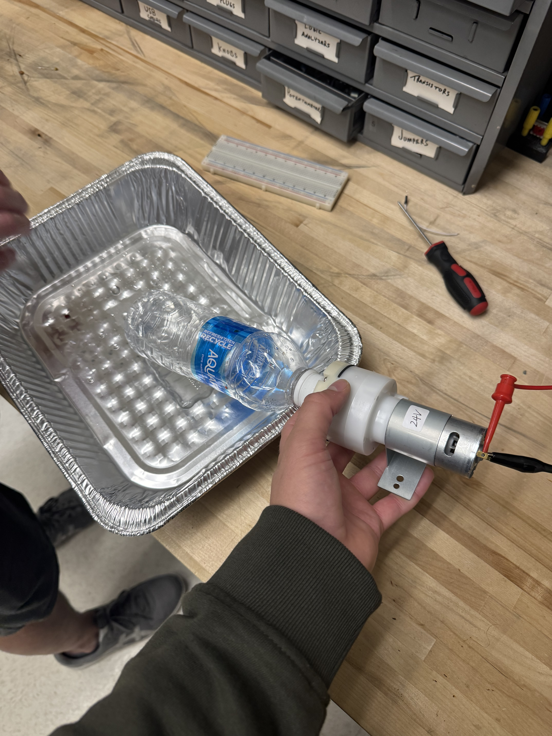
Pictures/IMG_3029.jpg
